amweerasekara/Peltier-thermoelectric-measuring-device/README.md

# Peltier_thermoelectric_measure
The two temperature sensors are used to measure the top and the bottom surfaces of the Peltier device. Both temperature values, load voltage, current and power generated were measured and values were shown on the OLED display and at the same time these data will be recorded to the SD card.
